alanjian85/raster-i/README.md

# Trinity
A simple FPGA GPU
