alanjian85/raster-i/renderer/hls_config.cfg

part=xc7a100tcsg324-1

[hls]
flow_target=vivado
package.output.format=ip_catalog
package.output.syn=false
clock=100MHz
syn.top=trinity_renderer
syn.cflags=-I include
package.ip.display_name=TrinityRenderer
csim.ldflags=-lSDL2
syn.interface.m_axi_addr64=0
cosim.ldflags=-lSDL2
csim.O=true
csim.code_analyzer=0
syn.interface.m_axi_max_write_burst_length=256
syn.interface.m_axi_max_read_burst_length=256
tb.cflags=-I include
tb.file=src/tb.cpp
syn.file=src/top.cpp
syn.file=src/math/math.cpp
syn.file=src/mesh.cpp
syn.file=src/fb.cpp
syn.file=src/texture.cpp
