alanjian85/raster-i/renderer/src/mesh.cpp

#include <mesh.hpp>

extern const Vec3f MESH_VERTICES[NR_MESH_VERTICES] = {
    Vec3f(-0.003216, -0.254268, -0.301877),
    Vec3f(0.009474, -0.409431, -0.292311),
    Vec3f(-0.163114, 0.258421, -0.123837),
    Vec3f(0.389624, 0.061341, -0.281277),
    Vec3f(-0.004854, 0.254792, -0.401779),
    Vec3f(-0.361017, 0.685185, -0.120988),
    Vec3f(-0.418997, -0.228343, -0.006683),
    Vec3f(-0.093001, -0.573407, 0.226652),
    Vec3f(-0.169588, -0.509672, 0.185163),
    Vec3f(-0.215428, -0.489269, 0.150879),
    Vec3f(0.186094, -0.086855, -0.096541),
    Vec3f(0.421152, 0.936394, 0.10688),
    Vec3f(0.002307, -1.10531, -0.108449),
    Vec3f(0.201353, -0.813703, 0.130062),
    Vec3f(0.793961, 1.42301, 0.227907),
    Vec3f(0.753973, 1.46046, 0.221549),
    Vec3f(0.784564, 1.46424, 0.196925),
    Vec3f(0.597313, 1.39819, 0.09153),
    Vec3f(0.518645, 1.09131, 0.111823),
    Vec3f(0.116895, -0.941081, 0.087101),
    Vec3f(0.144539, -0.947569, 0.05425),
    Vec3f(-0.069326, -0.861985, 0.326534),
    Vec3f(-0.062509, -0.903626, 0.291817),
    Vec3f(0.121578, -0.904855, 0.274114),
    Vec3f(0.138928, -0.977253, 0.095144),
    Vec3f(0.036103, -0.945343, 0.309293),
    Vec3f(0.020248, -1.01042, 0.328218),
    Vec3f(0.158499, -1.05218, 0.110823),
    Vec3f(0.16571, -1.07713, 0.058882),
    Vec3f(-0.007, -1.01126, 0.360541),
    Vec3f(0.156714, -1.06138, 0.165323),
    Vec3f(0.20465, -1.07058, 0.136791),
    Vec3f(0.156047, -1.04777, 0.147044),
    Vec3f(0.267859, -1.096, 0.210586),
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
    Vec3f(-0.378935, 0.054589, -0.232286),
    Vec3f(-0.314045, 0.044046, -0.316336),
    Vec3f(-0.287222, 0.018361, -0.326427),
    Vec3f(-0.387032, 0.014437, -0.062144),
    Vec3f(-0.401596, 0.031962, -0.08165),
    Vec3f(-0.363188, 0.027277, -0.038224),
    Vec3f(-0.248246, -0.074073, -0.369374),
    Vec3f(-0.350388, -0.000464, -0.197688),
    Vec3f(-0.444805, -0.023025, -0.073572),
    Vec3f(-0.363584, -0.009982, -0.127473),
    Vec3f(-0.408408, -0.014119, -0.095472),
    Vec3f(-0.329267, -0.071666, -0.023909),
    Vec3f(-0.353308, -0.036467, -0.209953),
    Vec3f(-0.410684, -0.037343, -0.062641),
    Vec3f(-0.788632, 1.36738, 0.066225),
    Vec3f(-0.925841, 1.37022, 0.154198),
    Vec3f(-0.73566, 1.34565, 0.115016),
    Vec3f(-0.86844, 1.34143, 0.168191),
    Vec3f(-0.759169, 1.31204, 0.060836),
    Vec3f(-0.730059, 1.29129, 0.157533),
    Vec3f(-0.844765, 1.29296, 0.140016),
    Vec3f(-0.754601, 1.20788, 0.167876),
    Vec3f(-0.699298, 1.21261, 0.095979),
    Vec3f(-0.757155, 1.19506, 0.153473),
};
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
