alanjian85/raster-i/renderer/include/texture.hpp

#pragma once

#include <cmath>
#include <cstdint>

#include <math/vec.hpp>
#include <utils/color.hpp>

#define TEXTURE_WIDTH 256
#define TEXTURE_HEIGHT 256

extern const uint32_t TEXTURE[TEXTURE_WIDTH * TEXTURE_HEIGHT];

inline RGB8 sample_texture(Vec2f uv) {
    int x = ceil(uv.x * (TEXTURE_WIDTH - 1));
    int y = ceil(uv.y * (TEXTURE_HEIGHT - 1));
    return RGB8::decode(TEXTURE[y * TEXTURE_WIDTH + x]);
}
