alanjian85/raster-i/(commit log)

2023-03-13 Upload Linux device driver implementation
2023-03-13 Upload the client application
    The client application is a program that uses SDL2 in userspace to
    display framebuffer data the driver read in from the FPGA framebuffer
    write core.
2023-04-27 Add Vivado RTL design for display using DMA
2023-07-28 Create Verilog blinking example
    This commit marks a new iteration of development. In this update, all
    files in the last iteration are deleted and are replaced by an example
    of blinking LED on Arty A7 development board that can be compiled
    together with F4PGA FOSS synthesis toolchain.
    [arty.xdc, top.v]
2023-08-07 Optimize the vertex shader
    This commit optimizes the computation of vertex positions by assuming
    that the width of each side of the triangle is 128, which is a power of
    2, and discard the flag use_dsp to give Vivado its choice to decide
    whether or not to use DSP.
2023-08-07 Implement perspective texture mapping correction
    [top.v]
2023-08-07 Add the reset mechanism to vertex shader
    [top.v]
2023-08-07 Simplify the circuit of calculating triangle vertices
2023-08-16 Change the HDL to Chisel
    This commit changes the HDL(harware description language) of this
    project to Chisel, a high level(in comparison with Verilog) hardware
    compiler framework targeting the Scala programming language, in order to
    simplify the process of developing hardwares and avoid doing redundant
    and trivial labors such as calculating the width of registers and wires
    manually.
    [arty.xdc, top.v]
2023-08-16 Rewrite the reset signal synchronizer in Chisel
    This commit removes all Verilog code in this project by rewriting the
    original reset signal synchronizer (two flip-flops plus one inverter)
    in Chisel.
    [arty.xdc, top.v]
2023-08-16 Add a custom clock of the pixel frequency
    This commit adds a clocking wizard IP of the pixel frequency that will
    be used in the future for pixel generation. And the code of blink is
    tweaked so that it can toggle the LED at the rate of 1 second using the
    pixel clock.
2023-08-16 Include more build instructions in README.md
    This commit puts build instructions of installing Vivado and setting up
    the Digilent board files to README.md to help user installing all the
    dependencies.
2023-08-17 Disable video output in blanking interval
    This commit renames Renderer to Shader and adds an active signal to the
    output of the VgaSignal module, which is used to disable the signals r,
    g and b while the current VGA signal is in the blanking interval.
2023-08-22 Add space between license headers and imports
    This commit adds a blank line between the license header of the source
    file and the first import (chisel3._ in the most common case).
2023-08-22 Update the info of development environment
    Update the info stored in the files in this project related to the
    version of Vivado and add .bloop, .metals and .vscode to .gitignore
    to not to track the settings of Visual Studio Code.
2023-08-23 Add the SDRAM controller IP
    Add the DDR3 controller IP called Memory Interface Generator (MIG) in
    Vivado. The controller IP provides access to the 256MB on-board SDRAM on
    Arty A7 and can be used to preserve space for the frame buffer, which
    will be created in the future.
2023-08-23 Import SdramController
    This commit import the newly created memory controller, SdramController,
    into the HDL design. This enables the abilty to access the frame buffer
    in the future.
2023-08-26 Implement LED blink demo using the on-board DDR3 SDRAM
    This commit makes use of the recently created DDR3 memory controller to
    store the state of the on-board LED and use it to create a producer-
    consumer pattern which can blinks the LED every second.
2023-08-31 Implement the display end of the framebuffer system
2023-09-01 Use AXI burst to read framebuffer scanlines
2023-09-01 Update the Ubuntu APT in GitHub flows
2023-09-24 Implement framebuffer writing cache
2023-10-01 Refactor the framebuffer reader
2023-10-03 Refactor framebuffer code
2023-10-04 Track top.v
2023-10-07 Refactor the framebuffer writer
2024-03-26 Upload HLS code
    [hls_config.cfg]
2024-06-17 Create headers for AABB and trigonometric functions
    [hls_config.cfg]
2024-06-18 Revise HLS code
    [hls_config.cfg]
2024-06-21 Implement tiled rendering
    [hls_config.cfg]
2024-06-21 Restore memory configurations
    [hls_config.cfg]
2024-06-23 Replace cube mesh by Blender Suzanne
    [mesh.cpp, mesh.hpp, top.cpp]
2024-07-08 Increase clock frequency to 100MHz
    [hls_config.cfg]
2024-07-09 Apply HLS pragmas
    [hls_config.cfg]
2024-07-10 Implement Phong shading
    [hls_config.cfg]
2024-07-11 Fix interpolation of positions
    [top.cpp]
2024-07-12 Use fixed-point numbers
    [hls_config.cfg]
2024-10-03 Add texture for ferris3d
    [hls_config.cfg]
