alanjian85/raster-i/(notices)

Notices in the files:
docs/README.md:
License: MIT
